schenfab/pedalier/README.md

View this project on [CADLAB.io](https://cadlab.io/project/1078). 

# pedalier
Hammond Organ MIDI pedal extension
