schenfab/pedalier/hw/eagle/schematic_layout/pedalier_gerber/README.txt

PCB DESCRIPTION
---------------

Dimension:              970mm x 20mm
Layer count:            2
Base material:          FR4, 35um Cu, 1.6mm
Solder mask:            yes
Silk screen:            no
Surface:                HAL or Gold
Min. track / gap size:  >= 0.2mm
Drill sizes:            0.3mm, 0.6mm, 3.6mm

FILES
-----

pedalier.cmp      copper layer TOP (gerber RS274x format)
pedalier.sol      copper layer BOTTOM (gerber RS274x format)
pedalier.stc      solder mask TOP (gerber RS274x format)
pedalier.sts      solder mask BOTTOM (gerber RS274x format)
pedalier.gpi      photo plotter information (text)
pedalier.drd      drill data (excellon format)
pedalier.dri      drill information (text)
