schenfab/pedalier/sw/doc/software_structure.pdf

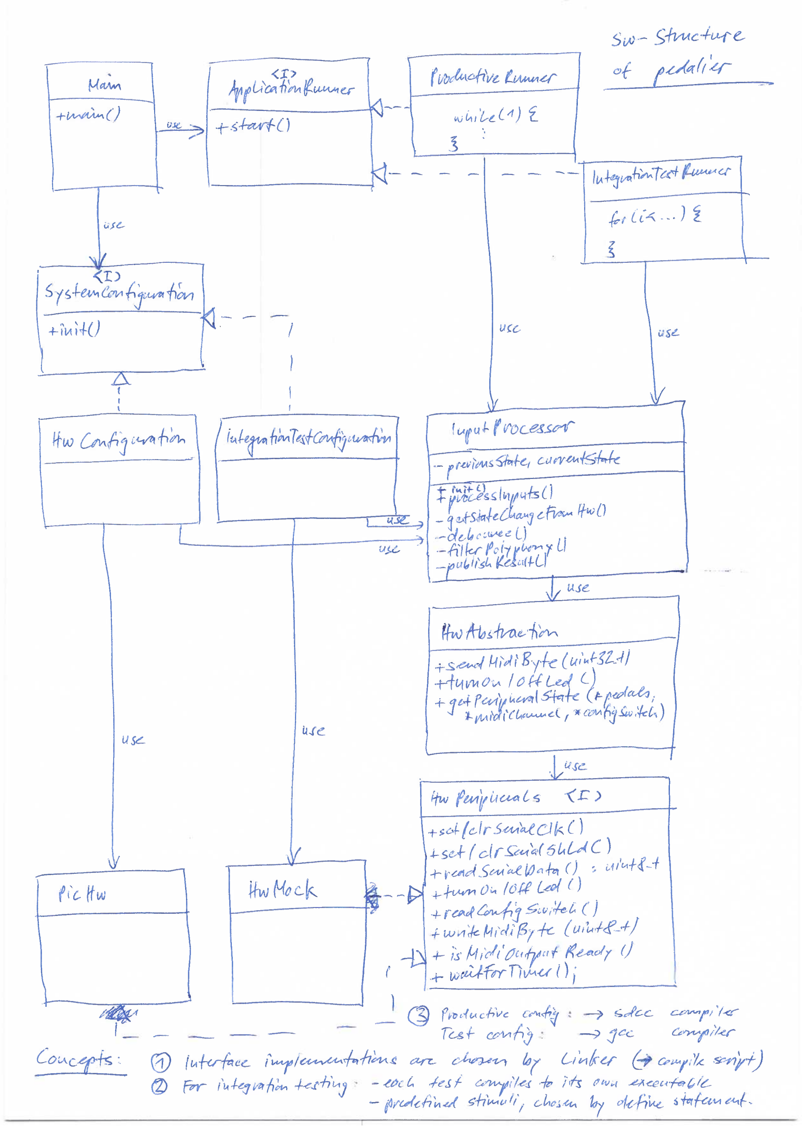
[picture p1: page 1]
