schenfab/pedalier/sw/build/expected_test_output/integration_test_1.txt

HwMock: resetting serial state to:
HwMock: Clk: 0, ShLd: 0
HwMock: resetting status LED to:
HwMock:                  Status LED: 0
HwMock: Clk: 0, ShLd: 1
HwMock: Clk: 0, ShLd: 1
HwMock:                  Data: 1
HwMock: Clk: 1, ShLd: 1
HwMock: Clk: 0, ShLd: 1
HwMock:                  Data: 0
HwMock: Clk: 1, ShLd: 1
HwMock: Clk: 0, ShLd: 1
HwMock:                  Data: 0
HwMock: Clk: 1, ShLd: 1
HwMock: Clk: 0, ShLd: 1
HwMock:                  Data: 0
HwMock: Clk: 1, ShLd: 1
HwMock: Clk: 0, ShLd: 1
HwMock:                  Data: 0
HwMock: Clk: 1, ShLd: 1
HwMock: Clk: 0, ShLd: 1
HwMock:                  Data: 0
HwMock: Clk: 1, ShLd: 1
HwMock: Clk: 0, ShLd: 1
HwMock:                  Data: 1
HwMock: Clk: 1, ShLd: 1
HwMock: Clk: 0, ShLd: 1
HwMock:                  Data: 0
HwMock: Clk: 1, ShLd: 1
HwMock: Clk: 0, ShLd: 1
HwMock:                  Data: 1
HwMock: Clk: 1, ShLd: 1
HwMock: Clk: 0, ShLd: 1
HwMock:                  Data: 1
HwMock: Clk: 1, ShLd: 1
HwMock: Clk: 0, ShLd: 1
HwMock:                  Data: 1
HwMock: Clk: 1, ShLd: 1
HwMock: Clk: 0, ShLd: 1
HwMock:                  Data: 1
HwMock: Clk: 1, ShLd: 1
HwMock: Clk: 0, ShLd: 1
HwMock:                  Data: 1
HwMock: Clk: 1, ShLd: 1
HwMock: Clk: 0, ShLd: 1
HwMock:                  Data: 1
HwMock: Clk: 1, ShLd: 1
HwMock: Clk: 0, ShLd: 1
HwMock:                  Data: 1
HwMock: Clk: 1, ShLd: 1
HwMock: Clk: 0, ShLd: 1
HwMock:                  Data: 1
HwMock: Clk: 1, ShLd: 1
HwMock: Clk: 0, ShLd: 1
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
HwMock:                          MIDI output ready: 0
HwMock:                          MIDI output ready: 1
HwMock:                  MIDI TX: 0x20
HwMock:                          MIDI output ready: 0
HwMock:                          MIDI output ready: 1
HwMock:                  MIDI TX: 0x00
