schenfab/pedalier/hw/eagle/schematic_layout/pedalier.sch.pdf

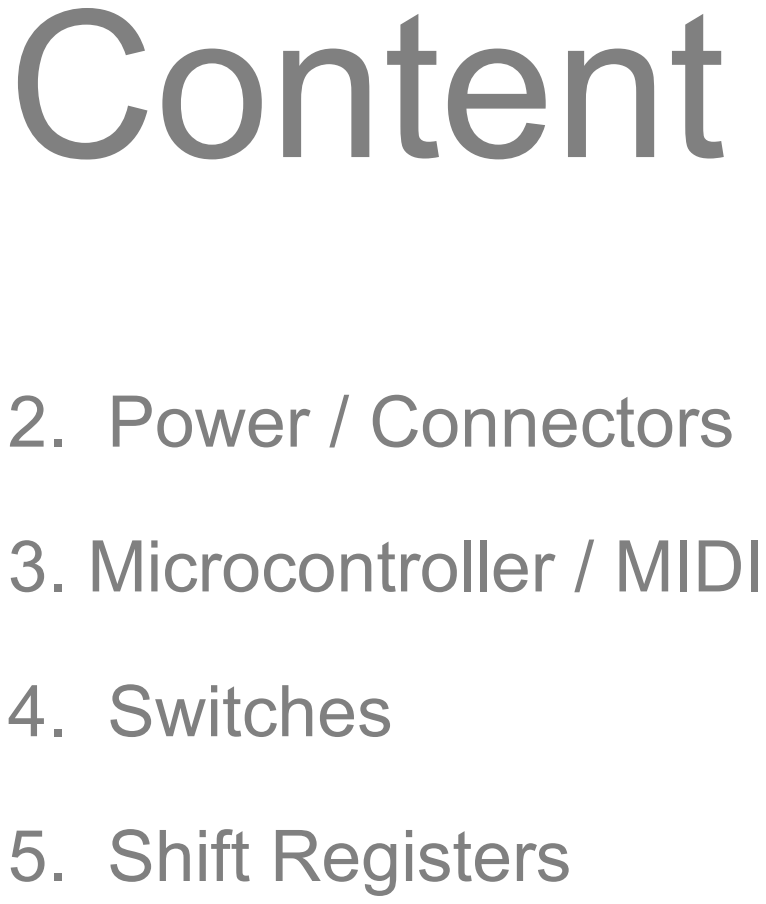
[picture p2: page 1]

2. Power / Connectors 3. Microcontroller / MIDI

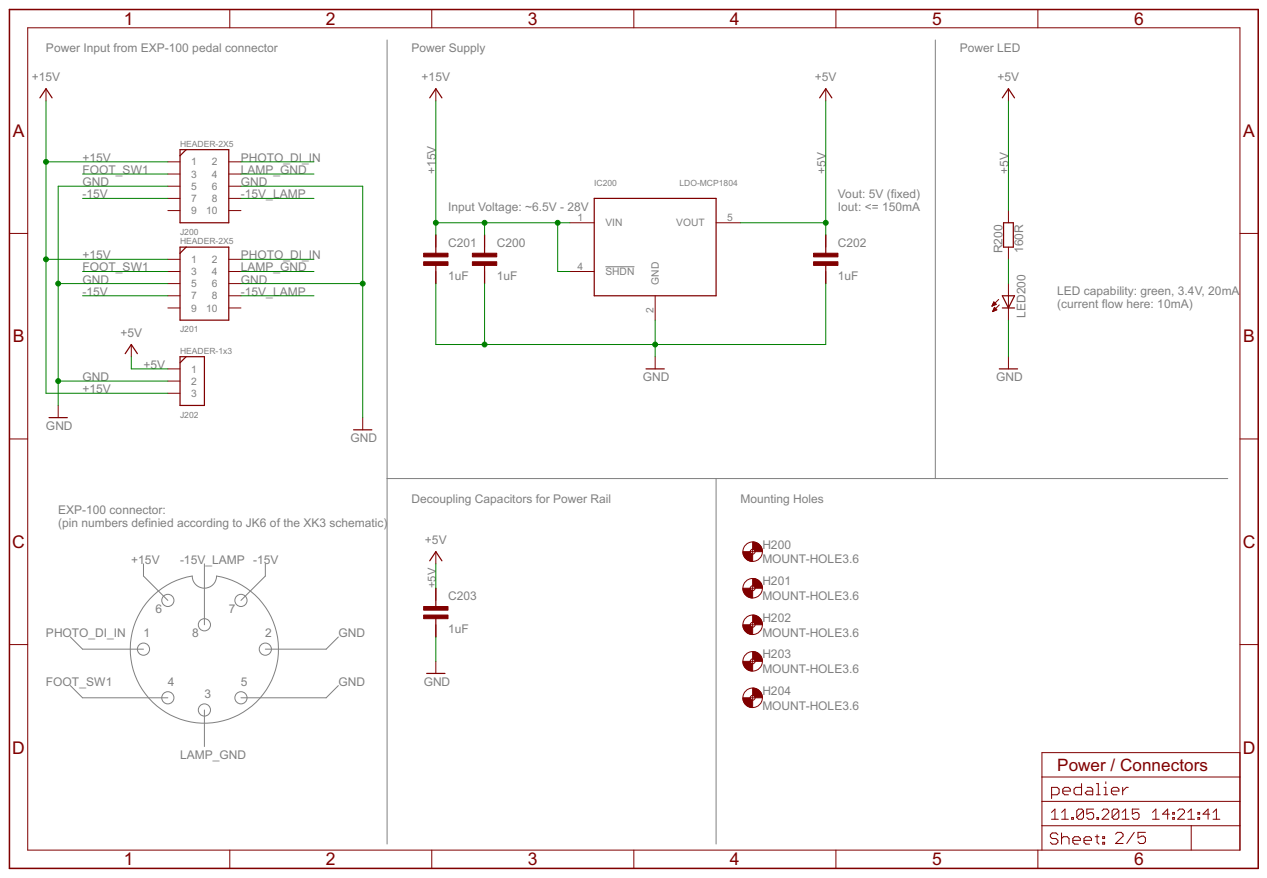
[picture p3: page 2]

EXP-100 connector: (pin numbers definied according to JK6 of the XK3 schematic)

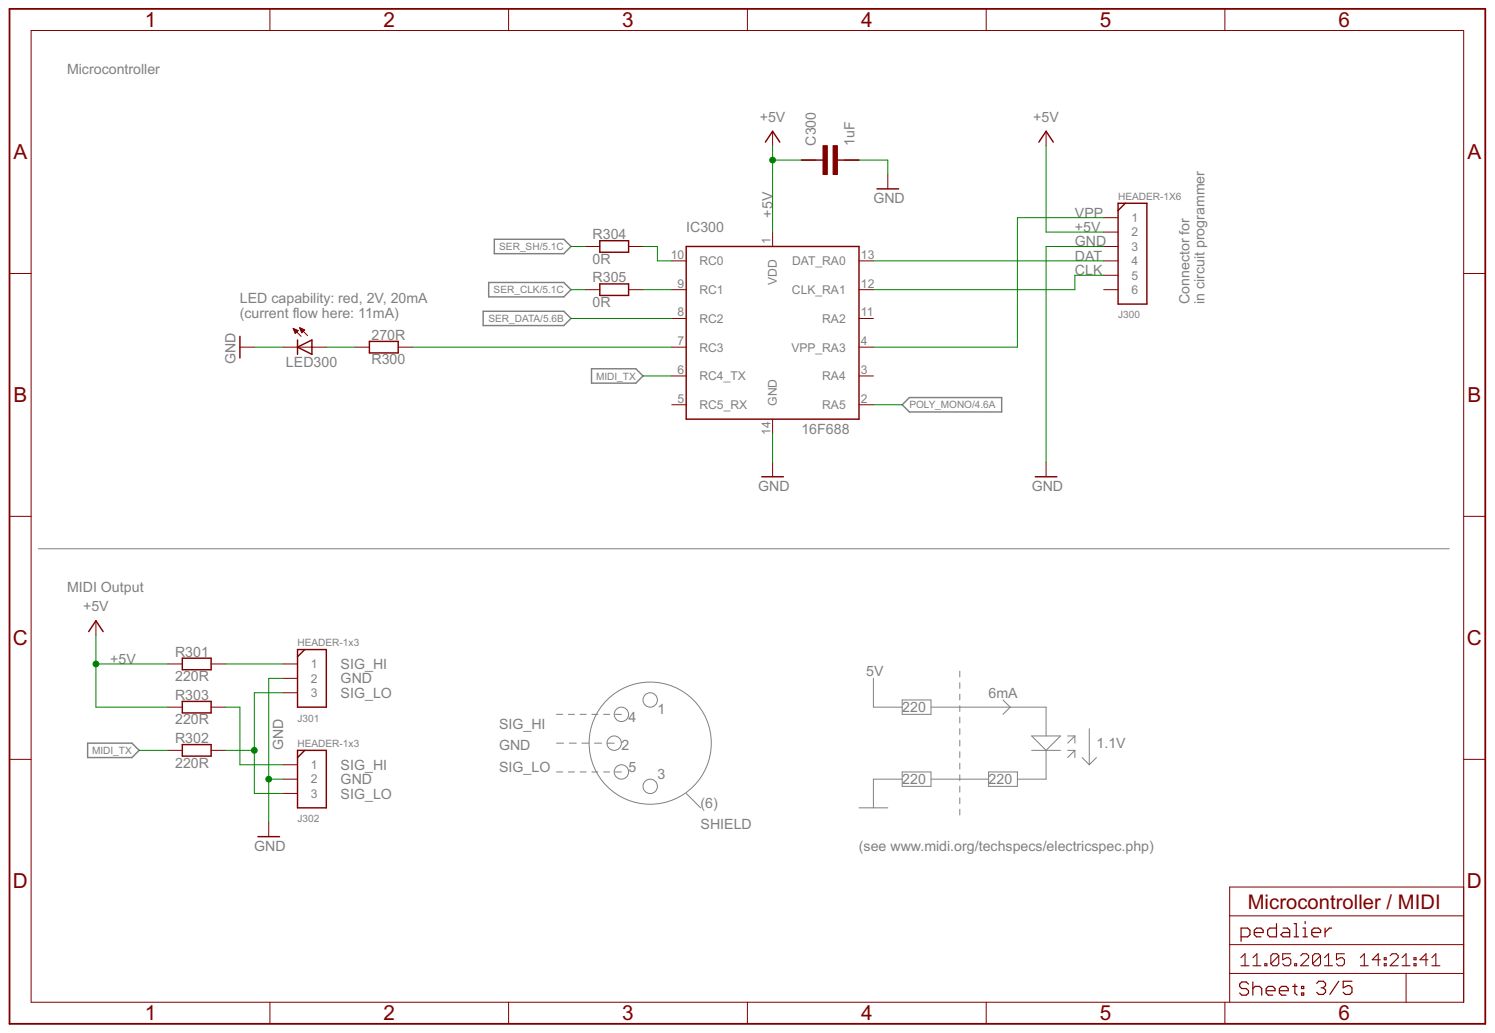
[picture p4: page 3]

(see www.midi.org/techspecs/electricspec.php)

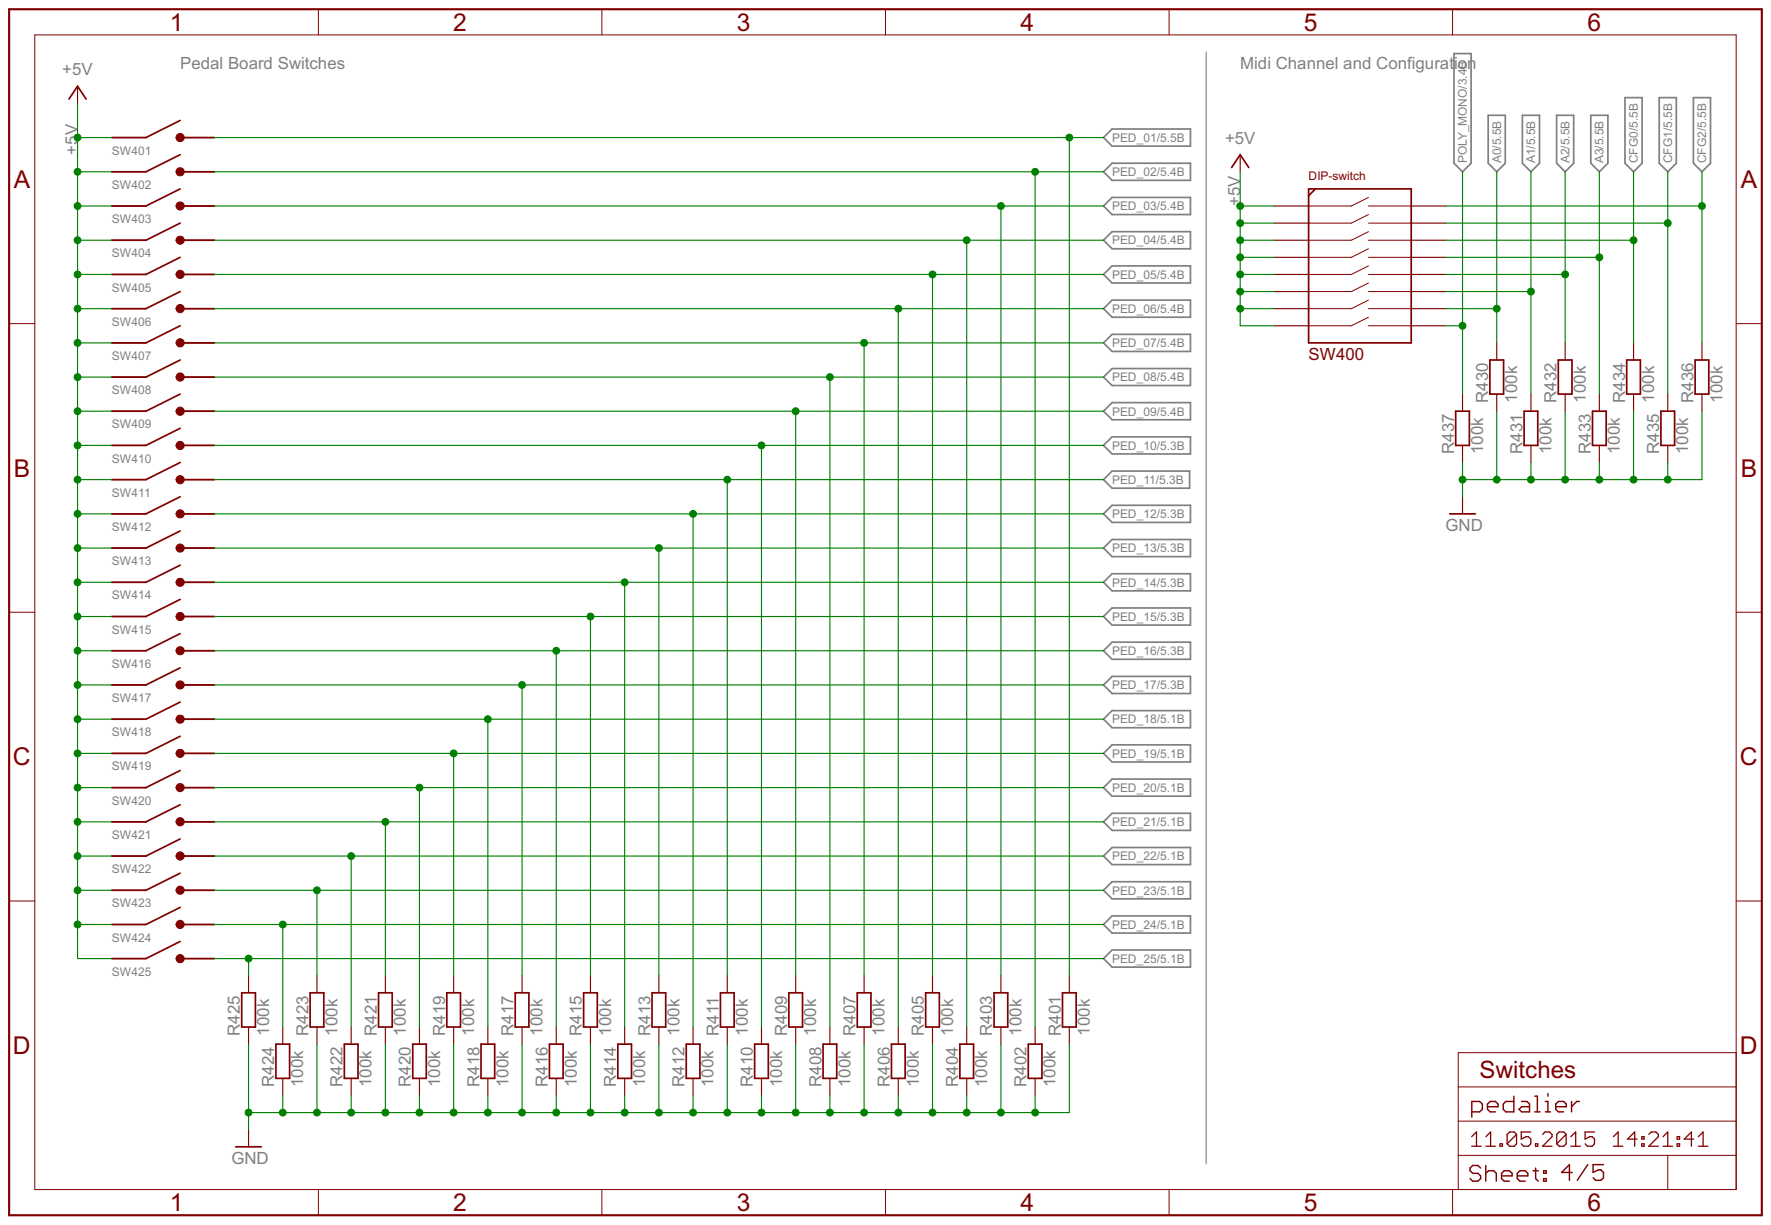
[picture p5: page 4]

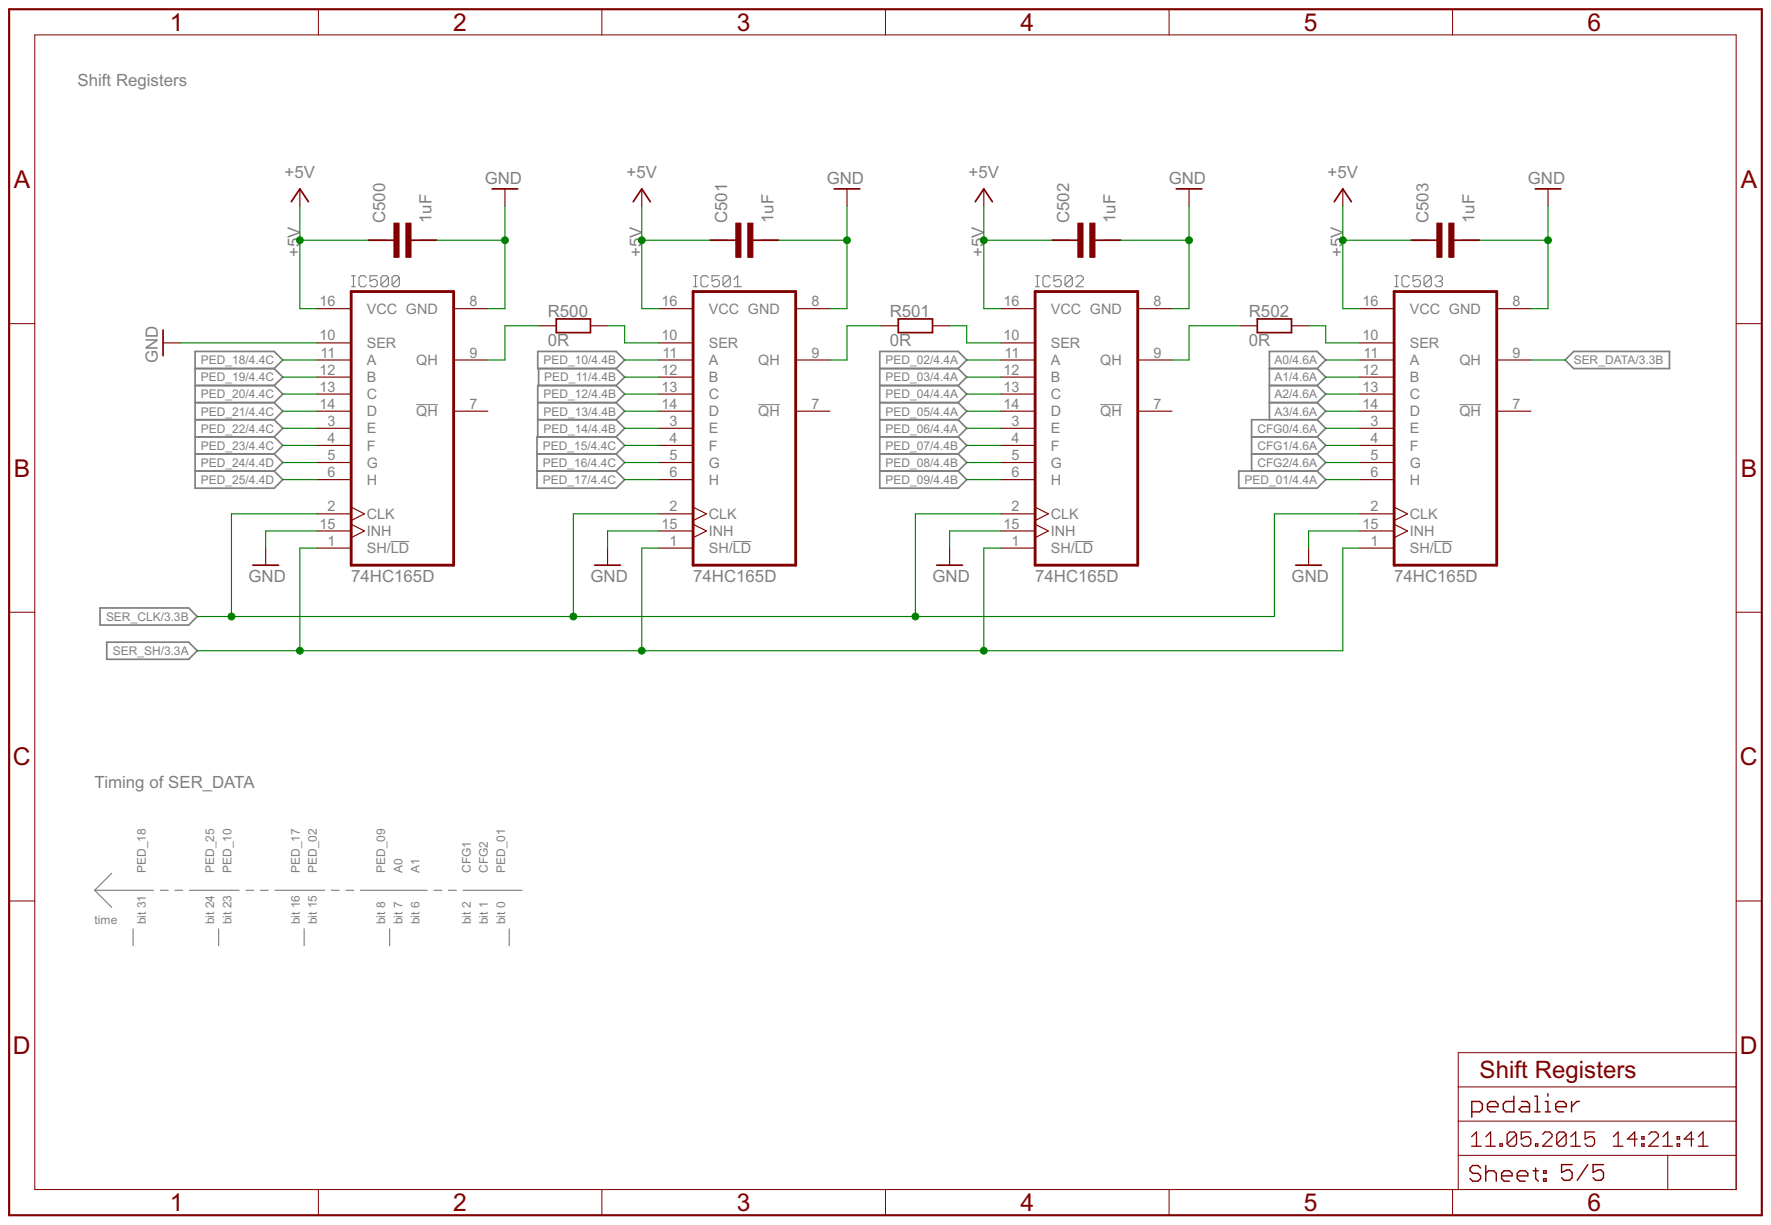
[picture p6: page 5]
