schenfab/pedalier/hw/eagle/schematic_layout/pedalier.brd

## EAGLE design hw/eagle/schematic_layout/pedalier.brd (2015-05-11)

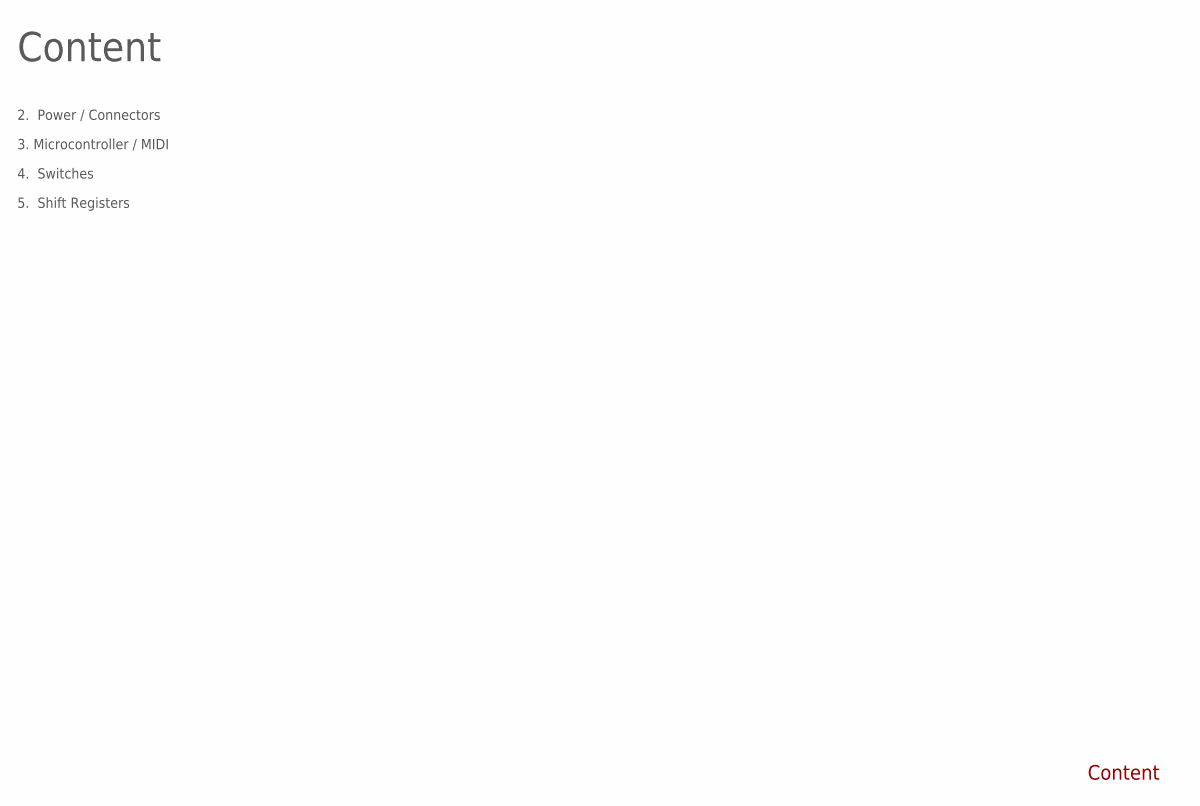
[picture p11: schematic pedalier.sch, sheet 1]

Notes on the sheet:
Content
2. Power / Connectors
3. Microcontroller / MIDI
4. Switches
5. Shift Registers

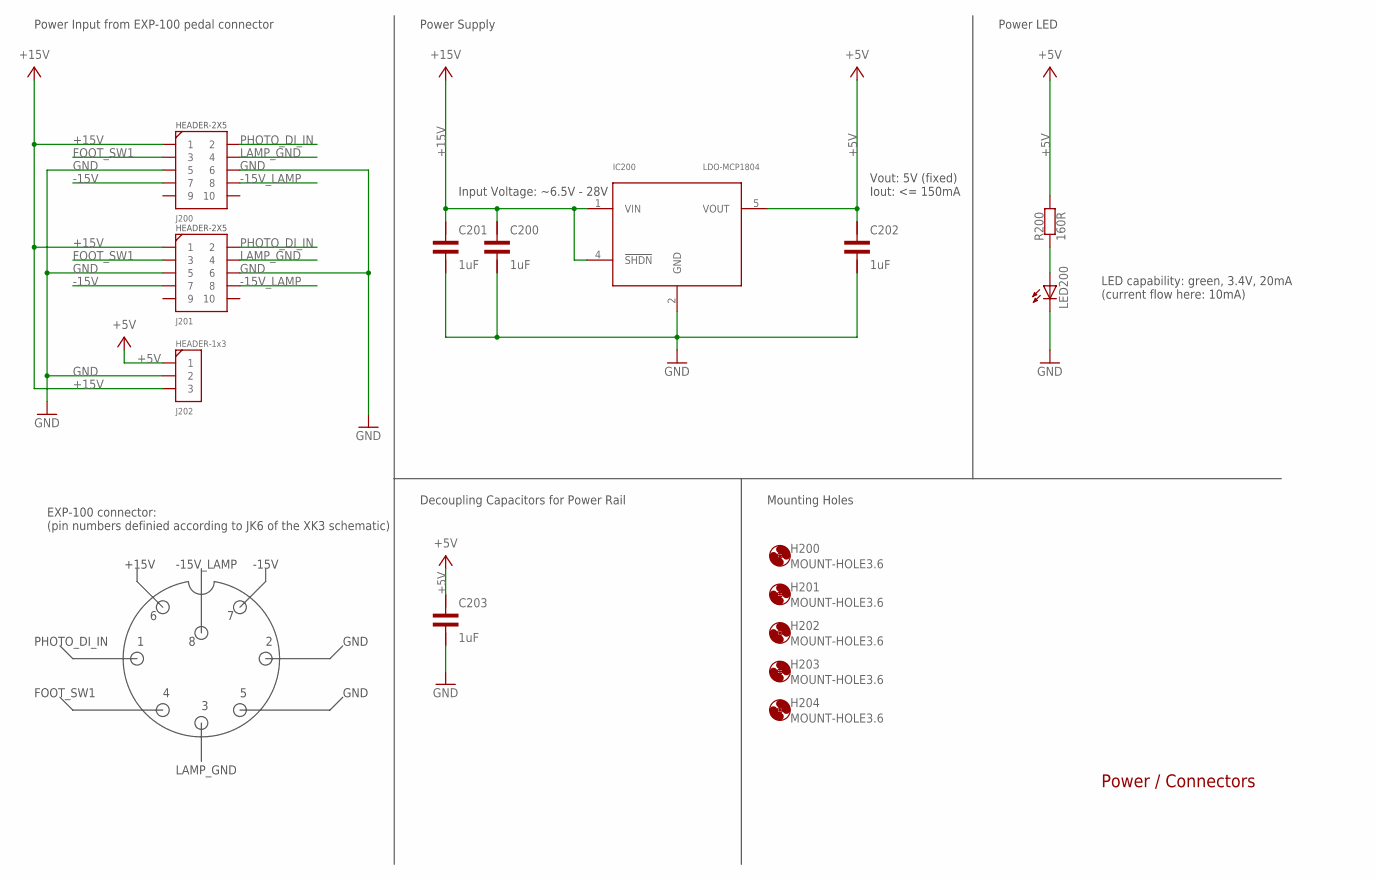
[picture p12: schematic pedalier.sch, sheet 2]

Parts:
C200, C201, C202, C203: 1uF; C1206
H200, H201, H202, H203, H204: MOUNT-HOLE3.6; 3,6
IC200: LDO-MCP1804; SOT23-5
J200, J201: HEADER-2X5
J202: HEADER-1X3
LED200: LED-BRIGHTEK; LED1206
R200: 160R; R1206

Connections:
+5V: C202.1, C203.1, IC200.5 (VOUT), J202.P$1 (1), R200.2; also elsewhere on the board
+15V: C200.1, C201.1, IC200.1 (VIN), IC200.4 (!SHDN), J200.P$1 (1), J201.P$1 (1), J202.P$3 (3)
-15V: J200.P$7 (7), J201.P$7 (7)
-15V_LAMP: J200.P$8 (8), J201.P$8 (8)
FOOT_SW1: J200.P$3 (3), J201.P$3 (3)
GND: C200.2, C201.2, C202.2, C203.2, IC200.2 (GND), J200.P$5 (5), J200.P$6 (6), J201.P$5 (5), J201.P$6 (6), J202.P$2 (2), LED200.P$1 (C); also elsewhere on the board
LAMP_GND: J200.P$4 (4), J201.P$4 (4)
unnamed: LED200.P$2 (A), R200.1
PHOTO_DI_IN: J200.P$2 (2), J201.P$2 (2)

Notes on the sheet:
Power / Connectors
Power Input from EXP-100 pedal connector
Power Supply
Power LED
Vout: 5V (fixed) Iout: <= 150mA
+15V
-15V
PHOTO_DI_IN
FOOT_SW1
LAMP_GND
GND
-15V_LAMP
EXP-100 connector: (pin numbers definied according to JK6 of the XK3 schematic)
LED capability: green, 3.4V, 20mA (current flow here: 10mA)
Decoupling Capacitors for Power Rail
Mounting Holes
Input Voltage: ~6.5V - 28V

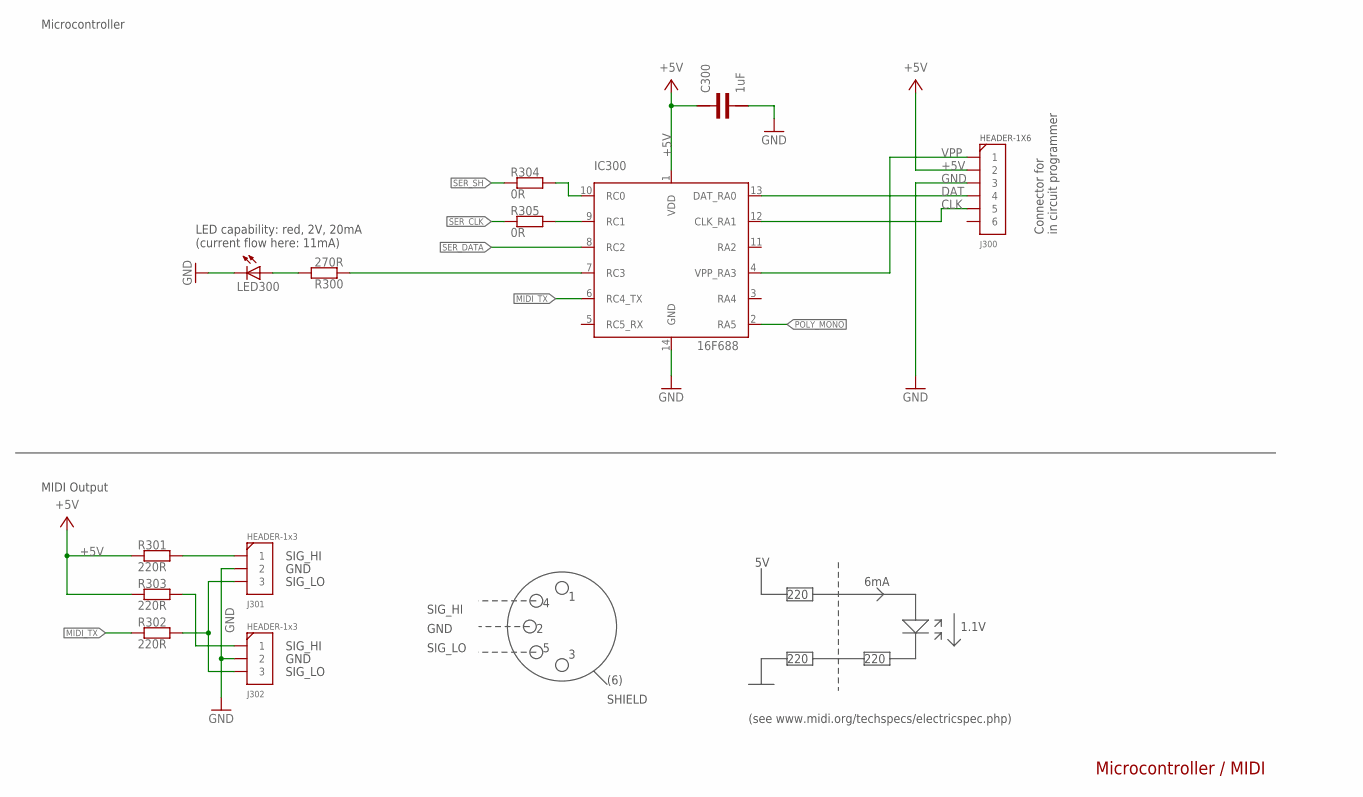
[picture p13: schematic pedalier.sch, sheet 3]

Parts:
C300: 1uF; C1206
IC300: PIC16F688SOIC14; SO14
J300: HEADER-1X6
J301, J302: HEADER-1X3
LED300: LED-BRIGHTEK; LED1206
R300: 270R; R1206
R301, R302, R303: 220R; R1206
R304, R305: 0R; R1206

Connections:
+5V: C300.1, IC300.1 (VDD), J300.P$2 (2), R301.1, R303.1; also elsewhere on the board
CLK: IC300.12 (CLK_RA1), J300.P$5 (5)
DAT: IC300.13 (DAT_RA0), J300.P$4 (4)
GND: C300.2, IC300.14 (GND), J300.P$3 (3), J301.P$2 (2), J302.P$2 (2), LED300.P$1 (C); also elsewhere on the board
MIDI_TX: IC300.6 (RC4_TX), R302.1
unnamed: J302.P$1 (1), R303.2
unnamed: LED300.P$2 (A), R300.2
unnamed: IC300.7 (RC3), R300.1
unnamed: J301.P$3 (3), J302.P$3 (3), R302.2
unnamed: J301.P$1 (1), R301.2
unnamed: IC300.10 (RC0), R304.2
unnamed: IC300.9 (RC1), R305.2
POLY_MONO: IC300.2 (RA5); also elsewhere on the board
SER_CLK: R305.1; also elsewhere on the board
SER_DATA: IC300.8 (RC2); also elsewhere on the board
SER_SH: R304.1; also elsewhere on the board
VPP: IC300.4 (VPP_RA3), J300.P$1 (1)

Notes on the sheet:
Microcontroller / MIDI
Connector for in circuit programmer
LED capability: red, 2V, 20mA (current flow here: 11mA)
Microcontroller
MIDI Output
(6)
(see www.midi.org/techspecs/electricspec.php)
SIG_LO
SIG_HI
GND
SHIELD
220
1.1V
6mA

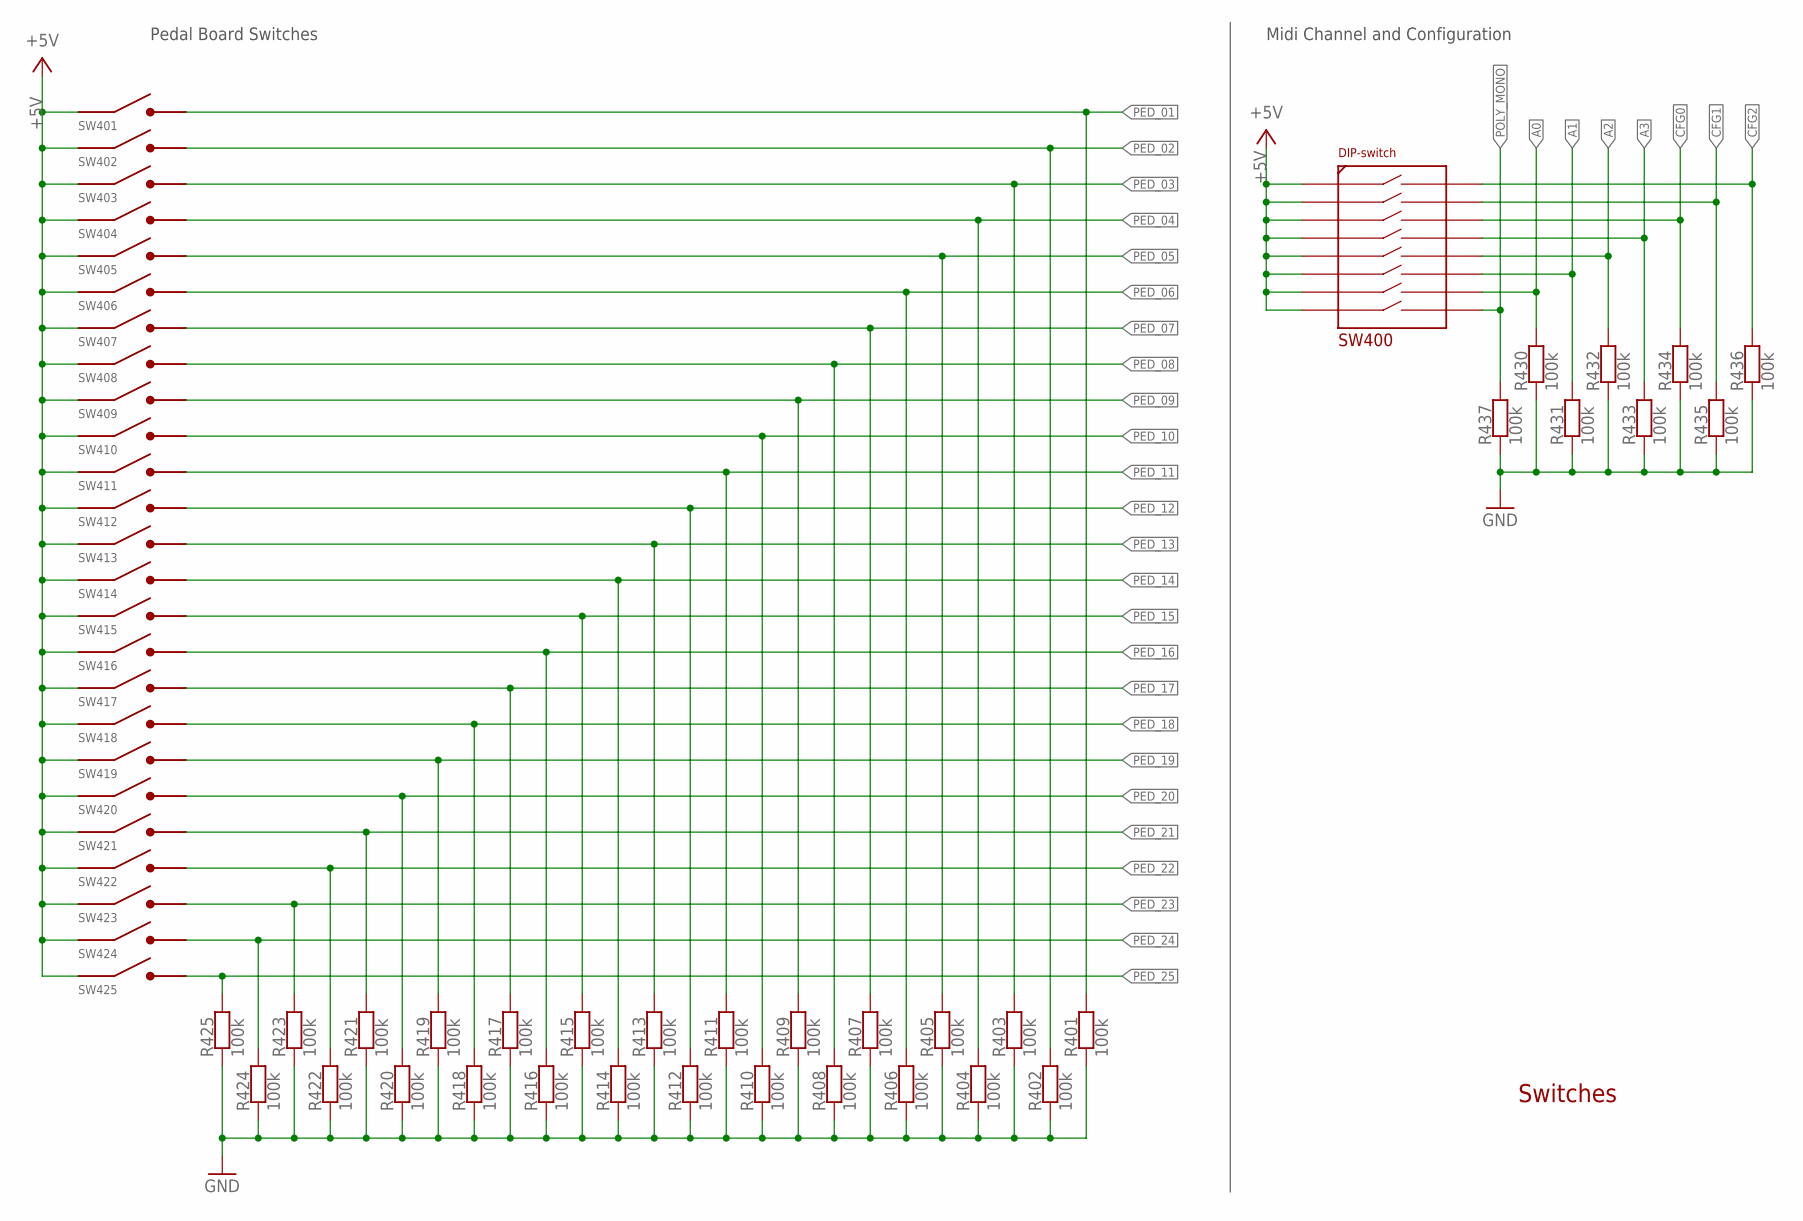
[picture p14: schematic pedalier.sch, sheet 4]

Parts:
R401, R402, R403, R404, R405, R406, R407, R408, R409, R410, R411, R412, R413, R414, R415, R416, R417, R418, R419, R420, R421, R422, R423, R424, R425, R430, R431, R432, R433, R434, R435, R436, R437: 100k; R1206
SW400: DIP-SW-8X; DIP-SW-8X-GULLWING
SW401, SW402, SW403, SW404, SW405, SW406, SW407, SW408, SW409, SW410, SW411, SW412, SW413, SW414, SW415, SW416, SW417, SW418, SW419, SW420, SW421, SW422, SW423, SW424, SW425: REED-SW; KSK-1A35-SMD

Connections:
+5V: SW400.P$1, SW400.P$3, SW400.P$5, SW400.P$7, SW400.P$9, SW400.P$11, SW400.P$13, SW400.P$15, SW401.1, SW402.1, SW403.1, SW404.1, SW405.1, SW406.1, SW407.1, SW408.1, SW409.1, SW410.1, SW411.1, SW412.1, SW413.1, SW414.1, SW415.1, SW416.1, SW417.1, SW418.1, SW419.1, SW420.1, SW421.1, SW422.1, SW423.1, SW424.1, SW425.1; also elsewhere on the board
A0: R430.2, SW400.P$14; also elsewhere on the board
A1: R431.2, SW400.P$12; also elsewhere on the board
A2: R432.2, SW400.P$10; also elsewhere on the board
A3: R433.2, SW400.P$8; also elsewhere on the board
CFG0: R434.2, SW400.P$6; also elsewhere on the board
CFG1: R435.2, SW400.P$4; also elsewhere on the board
CFG2: R436.2, SW400.P$2; also elsewhere on the board
GND: R401.1, R402.1, R403.1, R404.1, R405.1, R406.1, R407.1, R408.1, R409.1, R410.1, R411.1, R412.1, R413.1, R414.1, R415.1, R416.1, R417.1, R418.1, R419.1, R420.1, R421.1, R422.1, R423.1, R424.1, R425.1, R430.1, R431.1, R432.1, R433.1, R434.1, R435.1, R436.1, R437.1; also elsewhere on the board
PED_01: R401.2, SW401.2; also elsewhere on the board
PED_02: R402.2, SW402.2; also elsewhere on the board
PED_03: R403.2, SW403.2; also elsewhere on the board
PED_04: R404.2, SW404.2; also elsewhere on the board
PED_05: R405.2, SW405.2; also elsewhere on the board
PED_06: R406.2, SW406.2; also elsewhere on the board
PED_07: R407.2, SW407.2; also elsewhere on the board
PED_08: R408.2, SW408.2; also elsewhere on the board
PED_09: R409.2, SW409.2; also elsewhere on the board
PED_10: R410.2, SW410.2; also elsewhere on the board
PED_11: R411.2, SW411.2; also elsewhere on the board
PED_12: R412.2, SW412.2; also elsewhere on the board
PED_13: R413.2, SW413.2; also elsewhere on the board
PED_14: R414.2, SW414.2; also elsewhere on the board
PED_15: R415.2, SW415.2; also elsewhere on the board
PED_16: R416.2, SW416.2; also elsewhere on the board
PED_17: R417.2, SW417.2; also elsewhere on the board
PED_18: R418.2, SW418.2; also elsewhere on the board
PED_19: R419.2, SW419.2; also elsewhere on the board
PED_20: R420.2, SW420.2; also elsewhere on the board
PED_21: R421.2, SW421.2; also elsewhere on the board
PED_22: R422.2, SW422.2; also elsewhere on the board
PED_23: R423.2, SW423.2; also elsewhere on the board
PED_24: R424.2, SW424.2; also elsewhere on the board
PED_25: R425.2, SW425.2; also elsewhere on the board
POLY_MONO: R437.2, SW400.P$16; also elsewhere on the board

Notes on the sheet:
Switches
Pedal Board Switches
Midi Channel and Configuration

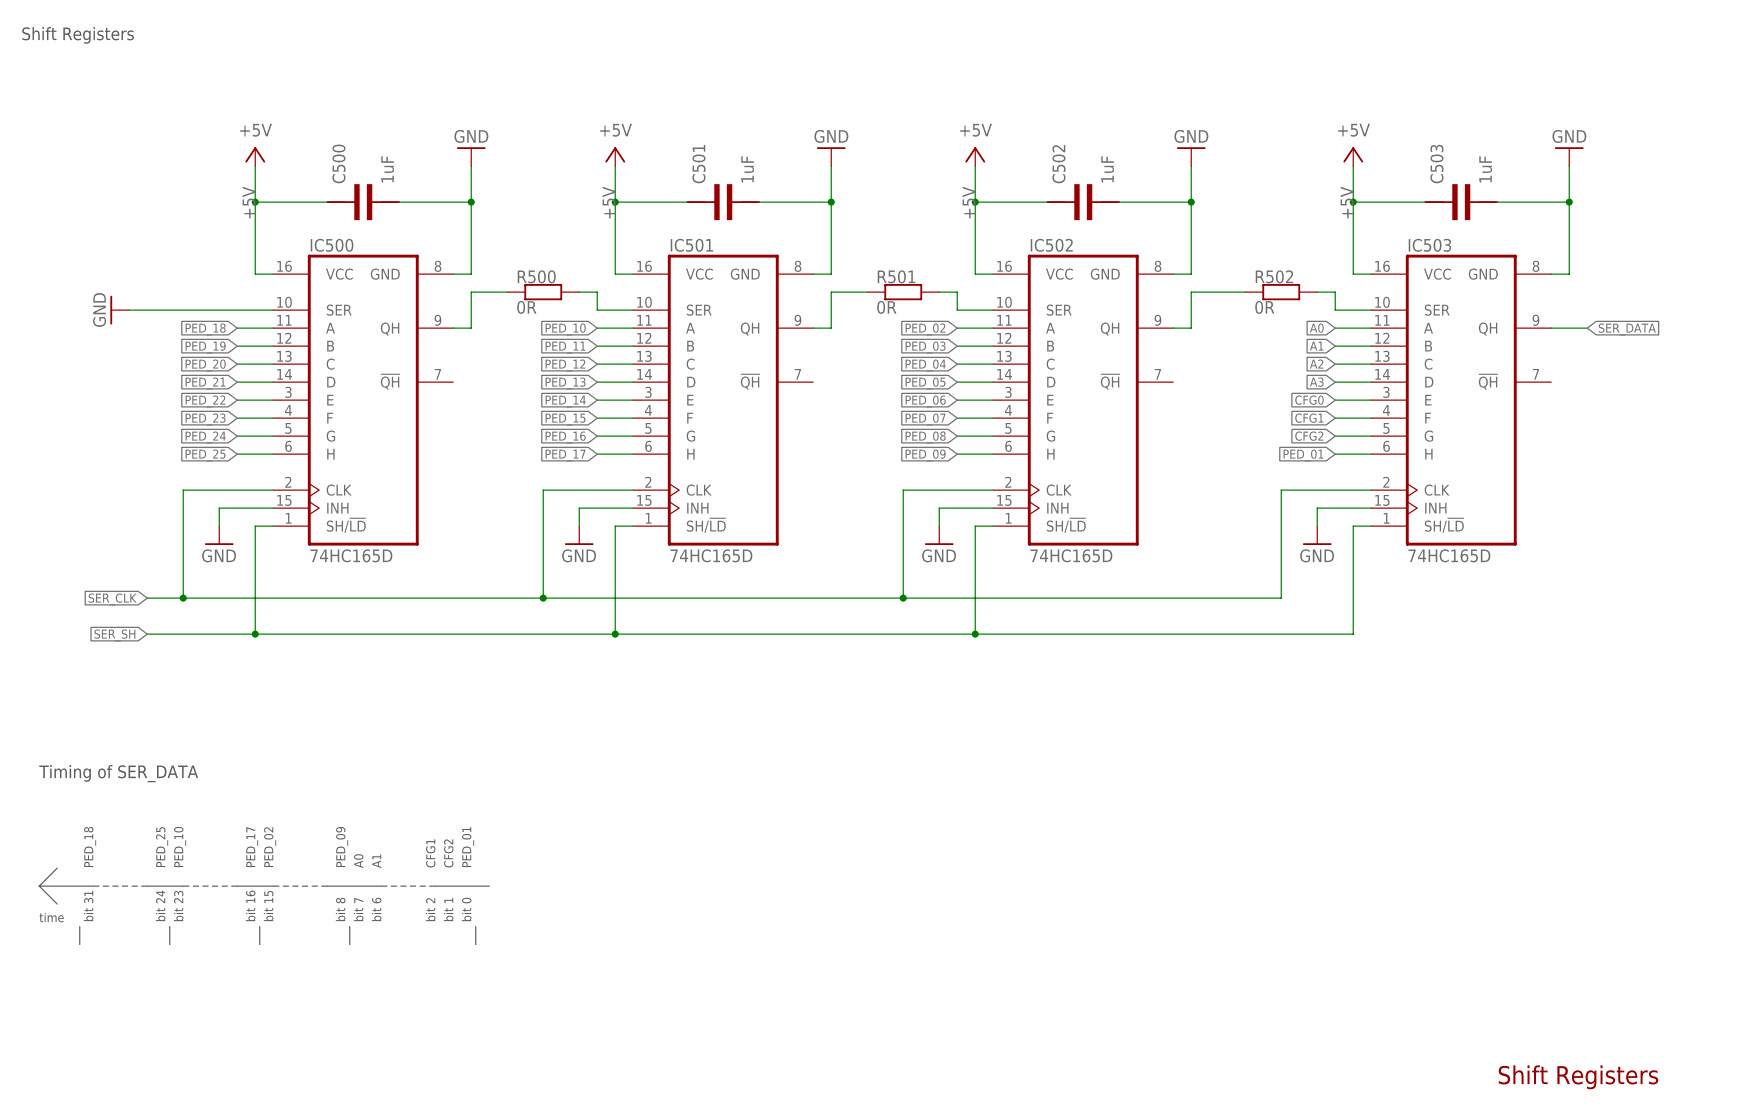
[picture p15: schematic pedalier.sch, sheet 5]

Parts:
C500, C501, C502, C503: 1uF; C1206
IC500, IC501, IC502, IC503: 74HC165D; SO16
R500, R501, R502: 0R; R1206

Connections:
+5V: C500.1, C501.1, C502.1, C503.1, IC500.16 (VCC), IC501.16 (VCC), IC502.16 (VCC), IC503.16 (VCC); also elsewhere on the board
A0: IC503.11 (A); also elsewhere on the board
A1: IC503.12 (B); also elsewhere on the board
A2: IC503.13 (C); also elsewhere on the board
A3: IC503.14 (D); also elsewhere on the board
CFG0: IC503.3 (E); also elsewhere on the board
CFG1: IC503.4 (F); also elsewhere on the board
CFG2: IC503.5 (G); also elsewhere on the board
GND: C500.2, C501.2, C502.2, C503.2, IC500.8 (GND), IC500.10 (SER), IC500.15 (INH), IC501.8 (GND), IC501.15 (INH), IC502.8 (GND), IC502.15 (INH), IC503.8 (GND), IC503.15 (INH); also elsewhere on the board
unnamed: IC500.9 (QH), R500.1
unnamed: IC501.9 (QH), R501.1
unnamed: IC502.10 (SER), R501.2
unnamed: IC502.9 (QH), R502.1
unnamed: IC503.10 (SER), R502.2
unnamed: IC501.10 (SER), R500.2
PED_01: IC503.6 (H); also elsewhere on the board
PED_02: IC502.11 (A); also elsewhere on the board
PED_03: IC502.12 (B); also elsewhere on the board
PED_04: IC502.13 (C); also elsewhere on the board
PED_05: IC502.14 (D); also elsewhere on the board
PED_06: IC502.3 (E); also elsewhere on the board
PED_07: IC502.4 (F); also elsewhere on the board
PED_08: IC502.5 (G); also elsewhere on the board
PED_09: IC502.6 (H); also elsewhere on the board
PED_10: IC501.11 (A); also elsewhere on the board
PED_11: IC501.12 (B); also elsewhere on the board
PED_12: IC501.13 (C); also elsewhere on the board
PED_13: IC501.14 (D); also elsewhere on the board
PED_14: IC501.3 (E); also elsewhere on the board
PED_15: IC501.4 (F); also elsewhere on the board
PED_16: IC501.5 (G); also elsewhere on the board
PED_17: IC501.6 (H); also elsewhere on the board
PED_18: IC500.11 (A); also elsewhere on the board
PED_19: IC500.12 (B); also elsewhere on the board
PED_20: IC500.13 (C); also elsewhere on the board
PED_21: IC500.14 (D); also elsewhere on the board
PED_22: IC500.3 (E); also elsewhere on the board
PED_23: IC500.4 (F); also elsewhere on the board
PED_24: IC500.5 (G); also elsewhere on the board
PED_25: IC500.6 (H); also elsewhere on the board
SER_CLK: IC500.2 (CLK), IC501.2 (CLK), IC502.2 (CLK), IC503.2 (CLK); also elsewhere on the board
SER_DATA: IC503.9 (QH); also elsewhere on the board
SER_SH: IC500.1 (SH/!LD), IC501.1 (SH/!LD), IC502.1 (SH/!LD), IC503.1 (SH/!LD); also elsewhere on the board

Notes on the sheet:
Shift Registers
CFG2
PED_01
PED_02
PED_09
PED_10
PED_17
PED_18
PED_25
time
bit 0
bit 1
bit 7
bit 6
bit 8
bit 15
bit 16
bit 23
bit 24
bit 31
Timing of SER_DATA
CFG1
bit 2

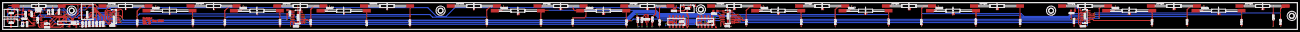
[picture p16: board pedalier.brd from above]

Board: 2 copper layers, 970.0 x 20.0 mm, 97 parts (0 on the bottom side), 62 nets.
