schenfab/pedalier/sw/src/main.c

// ***********************************************************************
// Firmware main class for pedalier
//
// This application can be either built with sdcc for a pic uC and productive
// environment or with gcc for a pc and integration testing.
// ***********************************************************************
//
//    This file is part of Pedalier.
//
//    Pedalier is free hard- and software: you can redistribute it and/or 
//    modify it under the terms of the GNU General Public License as 
//    published by the Free Software Foundation, either version 3 of the 
//    License, or (at your option) any later version.
//
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
// Include the SystemConfiguration interface
#include "system_configuration.h"

// Include the ApplicationRunner interface 
#include "application_runner.h"


void main() {
	// Initialize the system
	systemConfiguration_init();
	// Run the application
	applicationRunner_start();
}
