schenfab/pedalier/sw/src/pic_hw.c

// ***********************************************************************
// Implementation of the PicHw class
// ***********************************************************************
//
//    This file is part of Pedalier.
//
//    Pedalier is free hard- and software: you can redistribute it and/or 
//    modify it under the terms of the GNU General Public License as 
//    published by the Free Software Foundation, either version 3 of the 
//    License, or (at your option) any later version.
//
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

// Include implemented interface HwPeripherals
#include "hw_peripherals.h"

// Include class definition
#include "pic_hw.h"

// Include pic register definitions
#include "pic_registers.h"


/**************************************************************************
 * Configuration Word Register
 **************************************************************************/
// 15..12: Reserved  0
//     11: FCMEN     0     Failsafe clock monitor disabled
//     10: IESO      0     Int/Ext switchover disabled
// 09..08: BOREN     00    BOR disabled
//                   = 0x00
//     07: CPDn      1     Data memory code protection disabled
//     06: CPn       1     Program memory code protection disabled
//     05: MCLRE     0     MCLRn pin function is digital input
//     04: PWRTEn    1     Power-up timer is disabled
//     03: WDTE      0     Watchdog timer is disabled
// 02..00: FOSC      100   INTOSC and I/O function on RA4/RA5
//                   = 0xD4
unsigned int at 0x2007 configWord = 0x00D4;


// ***********************************************************************
// Private members
// ***********************************************************************
uint8_t state_portc;

// ***********************************************************************
// Private methods
// ***********************************************************************
void _picHw_configOscillator() {
	// OSCCON: Oscillator control register
	//      7: Reserved   0
	//   6..4: ICRF       111   8MHz
	//      3: OSTS       0     (ro)
	//      2: HTS        0     (ro)
	//      1: LTS        0     (ro)
	//      0: SCS        1     Internal oscillator for system clock
	OSCCON = 0x71;

	// OSCTUNE:
	//   Oscillator is running at the calibrated frequency
	OSCTUNE = 0x00;
}

void _picHw_disableInterrupts() {
	// INTCON: Interrupt controller register
	INTCON = 0x00;
}

void _picHw_configIOs() {
	// Pin configuration of port A
	// TRISA: Tri-State Port A register
	//     7: -    1
	//     6: -    1
	//     5: RA5  1  input (POLY_MONO)
	//     4: RA4  1  input (not used)
	//     3: RA3  1  input (not used)
	//     2: RA2  1  input (not used)
	//     1: RA1  1  input (not used)
	//     0: RA0  1  input (not used)
	TRISA = 0xFF;
	
	// Pin configuration of port C:
	// TRISC: Tri-State Port C register
	//     7: -    1
	//     6: -    1
	//     5: RC5  1  input (not used)
	//     4: RC4  0  output (MIDI_TX)
	//     3: RC3  0  output (Status LED)
	//     2: RC2  1  input (SER_DATA)
	//     1: RC1  0  output (SER_CLK)
	//     0: RC0  0  output (SER_CLK)
	TRISC = 0xE4;

	// Analog / digital input configuration of port C
	// ANSEL: Analog Select Register
	//     7: ANS7  0  AN7/RC3 is a digital input
	//     6: ANS6  0  AN6/RC2
	//     5: ANS5  0  AN5/RC1
	//     4: ANS4  0  AN4/RC0
	//     3: ANS3  0  AN3/RA4
	//     2: ANS2  0  AN2/RA2
	//     1: ANS1  0  AN1/RA1
	//     0: ANS0  0  AN0/RA0
	ANSEL = 0x00;

	// Default values of output ports:
	// SER_SH: 0
	// SER_CLK: 0
	// Status LED: 0 (-> off)
	// MIDI_TX: 0
	state_portc = 0x00;
	PORTC = state_portc;
}

void _picHw_configUart() {
	// Config baud rate generator
	// BAUDCTL: Baud rate control register
	//       7: ABDOVF   0  (read only)
	//       6: RCIDL    0  (read only)
	//       5: -        0  (reserved)
	//       4: SCKP     0  Transmit non-inverted data to the RB7/TX/CK pin
	//       3: BRG16    0  8-bit baud rate generator is used
	//       2: -        0  (reserved)
	//       1: WUE      0  Receiver is operating normally (wake up mode)
	//       0: ABDEN    0  Auto-Baud detect mode disabled
	BAUDCTL = 0x00;

	// SPBRG: 
	// 31250 baud @ 8MHz system clock: 
	// SYNC = 0, BRGH = 0, BRG16 = 0, SPBRG = 3 = 0x03
	SPBRG = 0x03;

	// SPBRGH: (only used for 16-bit baud rate generator)
	SPBRGH = 0x00;

	// TXSTA: Transmit status and control register
	//     7: CSRC    0  (don't care in asynchronous mode)
	//     6: TX9     0  8-bit transmission
	//     5: TXEN    1  Transmit enabled
	//     4: SYNC    0  Asynchronous mode
	//     3: SENDB   0  Sync break transmission completed (?)
	//     2: BRGH    0  Low speed
	//     1: TRMT    0  (read only) 
	//     0: TX9D    0  Ninth bit of transmit data
	TXSTA = 0x20;

	// RCSTA: Receive status and control register
	//     7: SPEN   1  Serial port enabled (configs RX / TX as input / output)
	//     6: RX9    0  8-bit reception
	//     5: SREN   0  (don't care)
	//     4: CREN   0  Receive disabled
	//     3: ADDEN  0  Address detection disabled
	//     2: FERR   0  (read only)
	//     1: OERR   0  (read only)
	//     0: RX9D   0  (read only)
	RCSTA = 0x80;
}

// ***********************************************************************
// Implementation of the public methods
// ***********************************************************************

void picHw_init() {
	_picHw_configOscillator();
	_picHw_disableInterrupts();
	_picHw_configIOs();
	_picHw_configUart();
}

// ***********************************************************************
// Implementation of the interface methods from HwPeripherals
// ***********************************************************************

void hwPeripherals_setSerialClk() {
	state_portc |= 0x02;   // Set RC1
	PORTC = state_portc;
}

void hwPeripherals_clrSerialClk() {
	state_portc &= ~(0x02);   // Clear RC1
	PORTC = state_portc;
}

void hwPeripherals_setSerialShLd() {
	state_portc |= 0x01;   // Set RC0
	PORTC = state_portc;
}

void hwPeripherals_clrSerialShLd() {
	state_portc &= ~(0x01);   // Clear RC0
	PORTC = state_portc;
}

uint8_t hwPeripherals_readSerialData() {
	uint8_t serData;
	serData = (PORTC & 0x04) >> 2;   // Read RC2
	return serData;
}

void hwPeripherals_turnOnLed() {
	state_portc |= 0x08;   // Set RC3
	PORTC = state_portc;
}

void hwPeripherals_turnOffLed() {
	state_portc &= ~(0x08);   // Clear RC3
	PORTC = state_portc;
}

uint8_t hwPeripherals_readMonoSwitch() {
	uint8_t monoSwitch;
	monoSwitch = (PORTA & 0x20) >> 5;   // Read RA5
	return monoSwitch;
}

void hwPeripherals_writeMidiByte(uint8_t byte) {
	TXREG = byte;
}

uint8_t hwPeripherals_isMidiOutputReady() {
	uint8_t pir1;
	// Poll the TXIF bit (bit 1) of the PIR1 register. It is set when the
	// EUSART is ready for a data byte, cleared otherwise.
	pir1 = PIR1;
	if((pir1 & 0x02) == 0) {
		return 0;
	}
	else {
		return 1;
	}
}
