schenfab/pedalier/sw/src/integration_test_vectors.c

// ***********************************************************************
// Statical test data for integration tests
// ***********************************************************************
//
//    This file is part of Pedalier.
//
//    Pedalier is free hard- and software: you can redistribute it and/or 
//    modify it under the terms of the GNU General Public License as 
//    published by the Free Software Foundation, either version 3 of the 
//    License, or (at your option) any later version.
//
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

#include <stdint.h>

#ifndef INTEGRATION_TEST_NO
	#error INTEGRATION_TEST_NO, which specifies the test case, is undefined

#elif INTEGRATION_TEST_NO == 1
// Default integration test:
//   - Mode: polyphonic
//   - Invert pedals: off
const unsigned int integrationTestRunner_loopCount = 13;

unsigned int _hwMock_readSerialData_array_index = 0;
const unsigned int _hwMock_readSerialData_array_length = 13*32;
// Data order:
// Byte 1: PED_01, CFG2,   CFG1,  CFG0,   A3,     A2,     A1,     A0
// Byte 2: PED_09, PED_08, PED07, PED_06, PED_05, PED_04, PED_03, PED_02
// Byte 3: PED_17, PED_16, PED15, PED_14, PED_13, PED_12, PED_11, PED_10
// Byte 4: PED_25, PED_24, PED23, PED_22, PED_21, PED_20, PED_19, PED_18
const uint8_t _hwMock_readSerialData_array[] = {
	1,0,0,0,0,0,1,0, 1,1,1,1,1,1,1,1, 1,1,1,1,1,1,1,1, 1,1,1,1,1,1,1,1,
	1,0,0,0,0,0,1,0, 1,1,1,1,1,1,1,1, 1,1,1,1,1,1,1,1, 0,1,1,1,1,1,1,1,
	0,0,0,0,0,0,1,0, 1,1,1,1,1,1,1,1, 1,1,1,1,1,1,1,1, 1,1,1,1,1,1,1,1,
	1,0,0,0,0,0,1,0, 1,1,1,1,1,1,1,1, 1,1,1,1,1,1,1,1, 1,1,1,1,1,1,1,1,

	1,0,0,0,0,0,1,1, 1,1,1,1,0,1,1,1, 1,1,1,1,1,1,1,1, 1,1,1,1,1,1,1,1,
	1,0,0,0,0,0,1,1, 1,1,1,1,0,1,1,1, 1,1,1,1,1,1,1,1, 1,1,1,1,1,1,1,1,
	1,0,0,0,0,0,1,1, 1,1,1,1,1,1,1,1, 1,1,1,1,1,1,1,1, 1,1,1,1,1,1,1,1,

	1,0,0,0,0,0,1,0, 1,0,1,1,1,1,1,1, 0,1,1,1,1,1,1,1, 1,1,1,1,1,1,1,1,
	1,0,0,0,0,0,1,0, 1,1,1,1,1,1,1,1, 1,1,1,1,1,1,1,1, 1,1,1,1,1,1,1,1,
	1,0,0,0,0,0,1,0, 1,1,1,1,1,1,1,1, 1,1,1,1,1,1,1,1, 1,1,1,1,1,1,1,1,

	1,0,0,0,0,0,1,0, 1,0,1,1,1,1,1,1, 0,1,1,1,1,1,1,1, 1,1,1,1,1,1,1,1,
	1,0,0,0,0,0,1,0, 1,1,1,1,1,1,1,1, 0,1,1,1,1,1,1,1, 1,1,1,1,1,1,1,1,
	1,0,0,0,0,0,1,0, 1,1,1,1,1,1,1,1, 1,1,1,1,1,1,1,1, 1,1,1,1,1,1,1,1
	};

unsigned int _hwMock_isMidiOutputReady_array_index = 0;
const unsigned int _hwMock_isMidiOutputReady_array_length = 10;
const uint8_t _hwMock_isMidiOutputReady_array[] = { 0,0,1,0,1,1,0,0,0,1 };

const uint8_t _hwMock_readMonoSwitch_value = 0;

#elif INTEGRATION_TEST_NO == 2
// Default integration test:
//   - Mode: monophonic
//   - Invert pedals: off
const unsigned int integrationTestRunner_loopCount = 15;

unsigned int _hwMock_readSerialData_array_index = 0;
const unsigned int _hwMock_readSerialData_array_length = 15*32;
// Data order:
// Byte 1: PED_01, CFG2,   CFG1,  CFG0,   A3,     A2,     A1,     A0
// Byte 2: PED_09, PED_08, PED07, PED_06, PED_05, PED_04, PED_03, PED_02
// Byte 3: PED_17, PED_16, PED15, PED_14, PED_13, PED_12, PED_11, PED_10
// Byte 4: PED_25, PED_24, PED23, PED_22, PED_21, PED_20, PED_19, PED_18
const uint8_t _hwMock_readSerialData_array[] = { 
	1,0,1,1,1,1,1,1, 1,1,1,1,1,1,1,1, 1,1,1,1,1,1,1,1, 1,1,1,1,1,1,1,1,
	1,0,1,1,1,1,1,1, 0,1,1,1,1,1,1,1, 1,1,1,1,1,1,1,1, 1,1,1,1,1,1,1,1,
	1,0,1,1,1,1,1,1, 0,0,1,1,1,1,1,1, 1,1,1,1,1,1,1,1, 1,1,1,1,1,1,1,1,
	1,0,1,1,1,1,1,1, 0,0,1,1,1,1,1,1, 1,1,1,1,1,1,1,1, 1,1,1,1,1,1,1,1,
	1,0,1,1,1,1,1,1, 0,1,1,1,1,1,1,1, 1,1,1,1,1,1,1,1, 1,1,1,1,1,1,1,1,
	1,0,1,1,1,1,1,1, 1,1,1,1,1,1,1,1, 1,1,1,1,1,1,1,1, 1,1,1,1,1,1,1,1,

	1,0,1,1,1,1,1,1, 0,1,1,1,1,1,1,1, 1,1,1,1,1,1,1,1, 1,1,1,1,1,1,1,1,
	1,0,1,1,1,1,1,1, 0,0,1,1,1,1,1,1, 1,1,1,1,1,1,1,1, 1,1,1,1,1,1,1,1,
	1,0,1,1,1,1,1,1, 0,0,1,1,1,1,1,1, 1,1,1,1,1,1,1,1, 1,1,1,1,1,1,1,1,
	1,0,1,1,1,1,1,1, 1,0,1,1,1,1,1,1, 1,1,1,1,1,1,1,1, 1,1,1,1,1,1,1,1,
	1,0,1,1,1,1,1,1, 1,1,1,1,1,1,1,1, 1,1,1,1,1,1,1,1, 1,1,1,1,1,1,1,1,

	1,0,1,1,1,1,1,1, 0,0,1,1,1,1,1,1, 1,1,1,1,1,1,1,1, 1,1,1,1,1,1,1,1,
	1,0,1,1,1,1,1,1, 0,0,1,1,1,1,1,1, 1,1,1,1,1,1,1,1, 1,1,1,1,1,1,1,1,
	1,0,1,1,1,1,1,1, 0,1,1,1,1,1,1,1, 1,1,1,1,1,1,1,1, 1,1,1,1,1,1,1,1,
	1,0,1,1,1,1,1,1, 1,1,1,1,1,1,1,1, 1,1,1,1,1,1,1,1, 1,1,1,1,1,1,1,1
	};

unsigned int _hwMock_isMidiOutputReady_array_index = 0;
const unsigned int _hwMock_isMidiOutputReady_array_length = 1;
const uint8_t _hwMock_isMidiOutputReady_array[] = { 1 };

const uint8_t _hwMock_readMonoSwitch_value = 1;

#elif INTEGRATION_TEST_NO == 3
// Default integration test:
//   - Mode: polyphonic
//   - Invert pedals: on
const unsigned int integrationTestRunner_loopCount = 9;

unsigned int _hwMock_readSerialData_array_index = 0;
const unsigned int _hwMock_readSerialData_array_length = 9*32;
// Data order:
// Byte 1: PED_01, CFG2,   CFG1,  CFG0,   A3,     A2,     A1,     A0
// Byte 2: PED_09, PED_08, PED07, PED_06, PED_05, PED_04, PED_03, PED_02
// Byte 3: PED_17, PED_16, PED15, PED_14, PED_13, PED_12, PED_11, PED_10
// Byte 4: PED_25, PED_24, PED23, PED_22, PED_21, PED_20, PED_19, PED_18
const uint8_t _hwMock_readSerialData_array[] = { 
	0,1,0,0,0,0,0,1, 0,0,0,0,0,0,0,0, 0,0,0,0,0,0,0,0, 0,0,0,0,0,0,0,0,
	0,1,0,0,0,0,0,1, 0,0,0,0,0,0,0,0, 0,0,0,0,0,0,0,0, 0,0,0,0,0,0,0,0,
	0,1,0,0,0,0,0,1, 0,0,0,0,0,0,0,0, 0,0,0,0,0,0,0,0, 0,0,0,0,0,0,0,0,

	1,1,0,0,0,0,0,1, 0,0,0,0,0,0,0,0, 0,0,0,0,0,0,0,0, 0,0,0,0,0,0,0,0,
	1,1,0,0,0,0,0,1, 0,0,0,0,0,0,0,0, 0,0,0,0,0,0,0,0, 0,0,0,0,0,0,0,0,
	1,1,0,0,0,0,0,1, 0,0,0,0,0,0,0,0, 0,0,0,0,0,0,0,0, 0,0,0,0,0,0,0,0,

	0,1,0,0,0,0,0,1, 0,0,0,0,0,0,0,0, 0,0,0,0,0,0,0,0, 0,0,0,0,0,0,0,0,
	0,1,0,0,0,0,0,1, 0,0,0,0,0,0,0,0, 0,0,0,0,0,0,0,0, 0,0,0,0,0,0,0,0,
	0,1,0,0,0,0,0,1, 0,0,0,0,0,0,0,0, 0,0,0,0,0,0,0,0, 0,0,0,0,0,0,0,0
	};

unsigned int _hwMock_isMidiOutputReady_array_index = 0;
const unsigned int _hwMock_isMidiOutputReady_array_length = 1;
const uint8_t _hwMock_isMidiOutputReady_array[] = { 1 };

const uint8_t _hwMock_readMonoSwitch_value = 0;

#endif
