schenfab/pedalier/(commit log)

2015-05-11 Addition of schematic, layout and gerber data
    [pedalier.brd, pedalier.sch]
2015-05-11 Fix for serial data order
    [hw_abstraction.c, integration_test_vectors.c]
2015-06-09 Refactored config switches. Added dedicated switch for inversion of the pedal state.
2015-06-09 Change of the interface to hw_abstraction due to stack depth problems when compiling for PIC
    [hw_abstraction.c, hw_abstraction.h, input_processor.c]
2015-06-11 Increased oscillator frequency from 4MHz to 8MHz
    [pic_hw.c]
2015-06-11 Added integration test for inverted pedals
    [integration_test_vectors.c]
2015-06-12 Bugfix: the first data bit is already there before the first clock cycle
    [hw_abstraction.c]
2015-06-12 Fix for readSerialData and readMonoSwitch
    [pic_hw.c]
2015-06-16 Moved pedal board one octave up (which is correct)
    [input_processor.c]
