schenfab/pedalier/(notices)

Notices in the files:
hw/eagle/schematic_layout/pedalier.brd:
GPL v3
